blesswater/beermon3/README.md

beermon3

This is the thrid resurection of my beer refrigerator controller.
