blesswater/beermon3/Notes.txt

192.168.166.185 - pi/S...

# To turn On I2C:
    sudo raspi-config 5,P5
#I2C Tools	
    sudo apt-get install -y i2c-tools
    i2cdetect -y 1
    i2cdump -y 1 0x25

# Raspberry Pi Image
    https://www.raspberrypi.org/downloads/raspbian/
    Raspbian Stretch w/ Desktop
    Ver: Oct 2018
    Rel: 10/9/2018
    Ker: 4.14
    SHA-265: 6e3aa76e21473ef316c0bfc9efa5c27a27fe46bd698f71de3e06e66b64a55500

# To get i2c working
https://www.studentcompanion.co.za/pic-microcontroller-communication-with-i2c-bus-mikroc/
https://www.raspberrypi.org/forums/viewtopic.php?t=71639

In /boot/config.txt
    CHANGE: dtparam=i2c_arm=on
    TO: dtparam=i2c_arm=on,i2c_arm_baudrate=32000
    TO: dtparam=i2c_arm=on,i2c_arm_baudrate=16000
->  TO: dtparam=i2c_arm=on,i2c_arm_baudrate=6000

Well... Now 32000 is working

To check:
    xxd /sys/class/i2c-adapter/i2c-1/of_node/clock-frequency
    Should show 7d00

# Assembly
https://en.wikipedia.org/wiki/PIC_instruction_listings

# To build beerChipTempLookup.c
cd ./Controller/beerChip.X
python ./makeBeerChipTempLookup.py > beerChipTempLookup.c

# SQLite3
sudo apt-get install sqlite3

# SQLite Commands
.q For quit
.show
.tables
.schema
.headers on

#
# To create beermon databases
#
CREATE TABLE Project (
    id INTEGER PRIMARY KEY AUTOINCREMENT, 
    proj_name TEXT,
    activity int,
    collection_state TEXT);
# activity: 0 -> inactive (stale) not recording; 
#           1 -> active data is being collected

CREATE TABLE Probes (
    id INTEGER PRIMARY KEY AUTOINCREMENT,
    proj_id INTEGER,
    probe_name TEXT,
    probe_chan INTEGER,
    type VARCHAR(8),
    min_range FLOAT,
    max_range FLOAT,
    control_probe INTEGER );

# Types:
#    NTC_00 -> Thermistor
#    Setpoint -> Control setpoint
#
# control_probe:
#    1 -> Can be used to control the refrigerator
#    0 -> Can not be used to control the refrigerator

CREATE TABLE Temperature (
   id INTEGER PRIMARY KEY AUTOINCREMENT,
   proj_id INTEGER,
   probe_id INTEGER,
   temp_time INTEGER,
   temp FLOAT );

CREATE TABLE Event (
    id INTEGER PRIMARY KEY AUTOINCREMENT,
    proj_id INTEGER,
    event_type TEXT,
    event_time INTEGER );

CREATE TABLE Scalar (
    id INTEGER PRIMARY KEY AUTOINCREMENT,
    type varchar(64),
    value varchar(512) );
or
CREATE TABLE Scalar (
    id INTEGER PRIMARY KEY AUTOINCREMENT,
    type TEXT,
    value TEXT );

# Dealing w/ timestamps
select date(temp_time, 'localtime'), 
       time(temp_time, 'localtime'), 
       datetime(temp_time, 'localtime'), 
       strftime( '%H', temp_time, 'localtime'), 
       temp 
from temperature 
where proj_id=1 and probe_id=3

#
# Session database
#
CREATE TABLE User (
    id INTEGER PRIMARY KEY AUTOINCREMENT,
    username TEXT,
    pwhash TEXT,
    priv INTEGER
);

CREATE TABLE Session (
    id INTEGER PRIMARY KEY AUTOINCREMENT,
    sessId TEXT,
    ipAddr TEXT,
    begin_time INTEGER,
    last_time INTEGER,
    privledge INTEGER
);

#
# Create a Project
#
INSERT INTO Project (proj_name) VALUES ('projName');
INSERT INTO Probes (proj_id, probe_name, probe_chan, type, min_range, max_range, control_probe)
VALUES (projId,'probeName,ch,'NTC_00',30.0, 90.0,cntl); 
INSERT INTO Probes (proj_id, probe_name, probe_chan, type, min_range, max_range, control_probe)
VALUES (projId,'probeName,0,'setpoint',30.0, 90.0,0);

# PW: blabla
INSERT INTO User (username, pwhash, priv)
VALUES ('kiosk', 
        '338466286ab294ab86042620b608b0157c96b9c725138023d68676a64db2cf34325ffb94ded84220f73fb8b5f99a107ca94a0b1647aec2de91e23aa63df36cd0$37a0bf15da254cc2a21b0a887c3ecdf1$',
        3
);

# PW: dontc4r3
INSERT INTO User (username, pwhash, priv)
VALUES ('testuser0',
        'b503cb8df109e6eda7218ae4edc0b31427d5f6eba8fd5d8dfeb9ee857c59ba8b8b8fc7d98ec9085ef5a572e95473f2a83a9d9b4711ca387d58477dec87aac16a$e85409c4cfcc4f0a8c466da3857adb7f$',
        3
);

# Generate PW
python
>>> import hashlib, uuid
>>> salt = uuid.uuid4().hex
>>> phash = hashlib.sha512('blabla' + salt).hexdigest() + '$' + salt + '$'

#
# Kiosk
#
From https://pimylifeup.com/raspberry-pi-kiosk

# Remove Junk
sudo apt-get purge wolfram-engine scratch scratch2 nuscratch sonic-pi idle3 -y
sudo apt-get purge smartsim java-common minecraft-pi libreoffice* -y

sudo apt-get clean
sudo apt-get autoremove -y

sudo apt-get update
sudo apt-get upgrade

# Install tools
sudo apt-get install xdotool unclutter sed

# Verify Autologin
sudo raspi-config
    3 Boot Options -> B1 Desktop / CLI -> B4 Desktop Autologin

# Enable kiosk service
systemctl enable kiosk.service

# uWSGI commands
sudo apt-get install uwsgi-plugin-python

systemctl stop uwsgi.service
uwsgi /etc/uwsgi/uwsgi.ini --honour-stdin

# Information for popups
https://www.w3schools.com/howto/tryit.asp?filename=tryhow_css_login_form_modal    

# Bootstrap
wget https://stackpath.bootstrapcdn.com/bootstrap/4.2.1/css/bootstrap.min.css
wget https://maxcdn.bootstrapcdn.com/bootstrap/4.1.3/js/bootstrap.min.js
<link rel="stylesheet" href="https://use.fontawesome.com/releases/v5.6.3/css/all.css" integrity="sha384-UHRtZLI+pbxtHCWp1t77Bi1L4ZtiqrqD80Kn4Z8NTSRyMA2Fd33n5dQ8lWUE00s/" crossorigin="anonymous">
wget https://use.fontawesome.com/releases/v5.6.3/css/all.css

#
# jQuery-knob
#
git clone https://github.com/aterrien/jQuery-Knob.git

#
# Turn off Beer Services
#
systemctl stop beermon-datacollect.service
systemctl stop beermon-persist.service

#
# Data Collection experiments
#
select datetime(avg(strftime('%s', temp_time)),'unixepoch'), count(*) from Temperature group by strftime('%s', temp_time) / 20 limit 5;

SELECT x.time_group, 
       DATETIME(AVG(STRFTIME('%s',x.centerTime)),'unixepoch'),
       MAX(x.prb1_avg), MAX(x.prb2_avg) 
FROM (
        SELECT CAST(strftime('%s', temp_time) / 20 AS INTEGER) AS time_group, 
            datetime(avg(strftime('%s', temp_time)),'unixepoch') AS centerTime,
            avg(temp) AS prb1_avg,
            0.0 as prb2_avg
        FROM Temperature WHERE probe_id=10
        GROUP BY strftime('%s', temp_time) / 20
    UNION
        SELECT CAST(strftime('%s', temp_time) / 20 AS INTEGER) AS time_group, 
               datetime(avg(strftime('%s', temp_time)),'unixepoch') AS certerTime,
               0.0 AS prb1_avg,
               avg(temp) as prb2_avg
        FROM Temperature WHERE probe_id=11
        GROUP BY strftime('%s', temp_time) / 20
) x GROUP BY x.time_group
