blesswater/beermon3/(list of files, cad)

Other CAD files:
Controller/beerChip.X/l.obj
