blesswater/beermon3/Docs/vma400_scheme.pdf

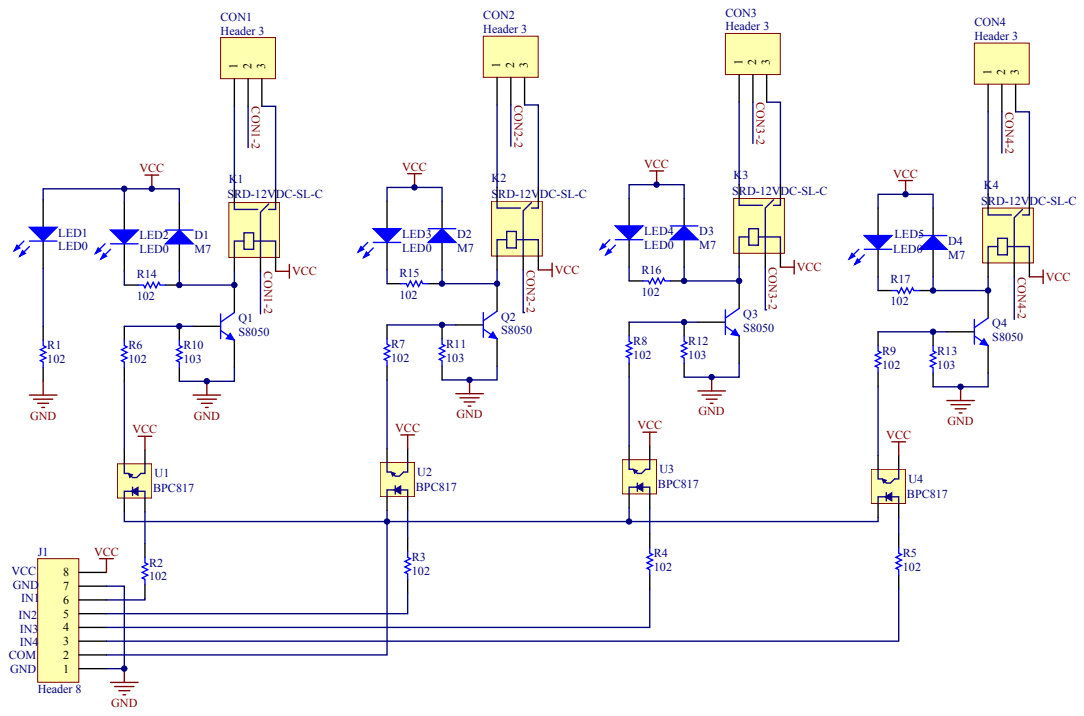
[picture p1: page 1]
