blesswater/beermon3/Hardware/beerSch00.brd

## EAGLE design Hardware/beerSch00.brd (2019-11-11)

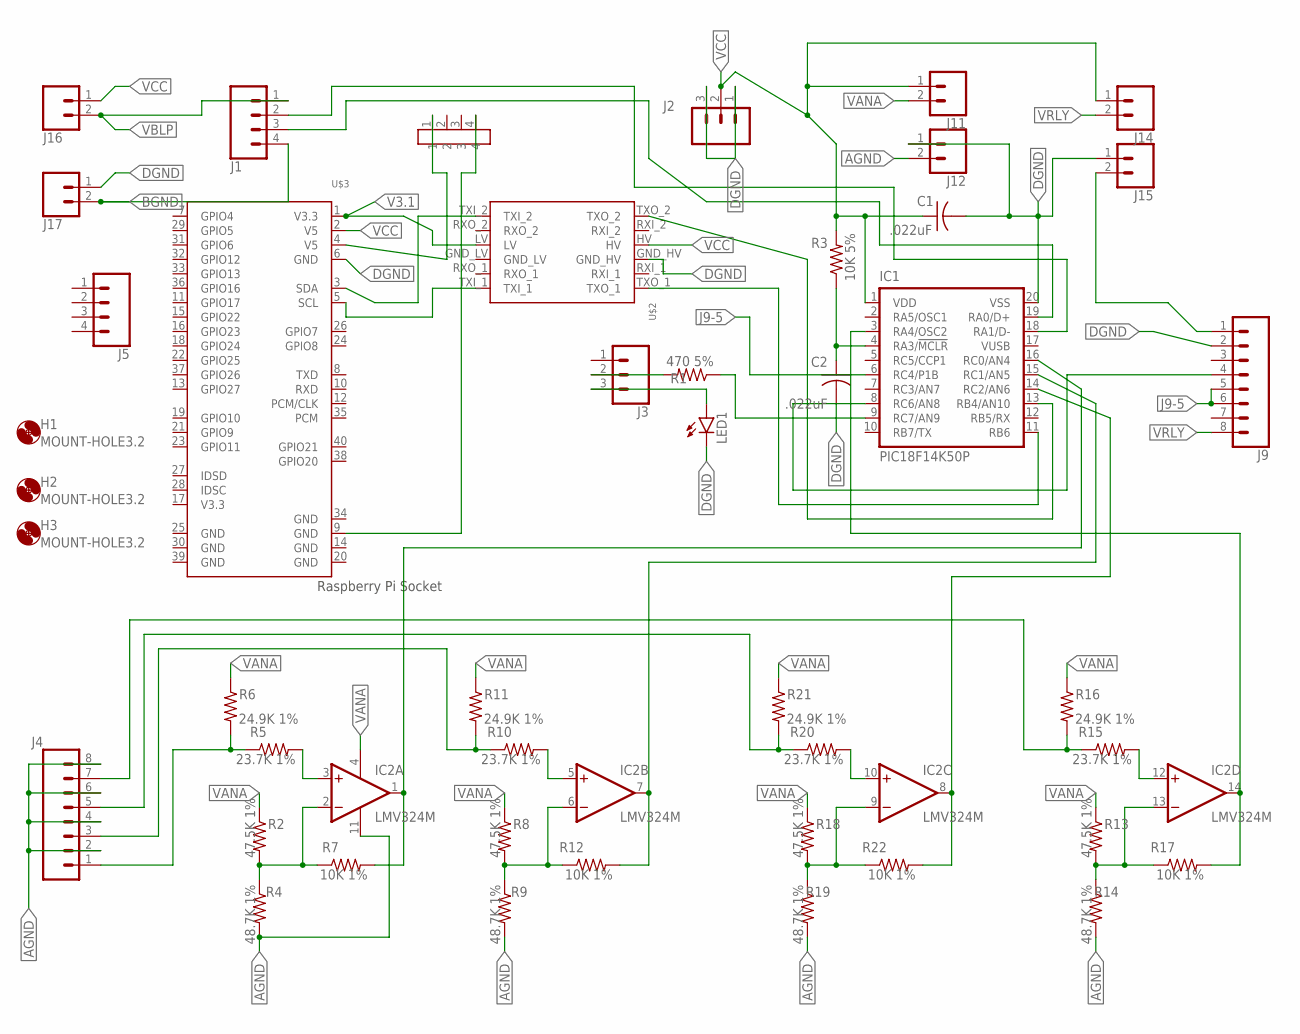
[picture p2: schematic beerSch00.sch]

Parts:
C1, C2: .022uF; C0805
H1, H2, H3: MOUNT-HOLE3.2; 3,2
IC1: PIC18F14K50P; DIL20
IC2: LMV324M; SO14
J1, J5: CONN_04; 1X04
J2, J3: CONN_03; 1X03
J4, J9: CONN_08"; 1X08
J11, J12, J14, J15, J16, J17: CONN_02; 1X02
LED1: LEDSML0805; SML0805
R1: 470 5%; R0603
R2, R8, R13, R18: 47.5K 1%; R0603
R3: 10K 5%; R0603
R4, R9, R14, R19: 48.7K 1%; R0603
R5, R10, R15, R20: 23.7K 1%; R0603
R6, R11, R16, R21: 24.9K 1%; R0603
R7, R12, R17, R22: 10K 1%; R0603
U$1: CONN_4; PINS_90
U$2: LEVELCONV; PLUG_THROUGHHOLE
U$3: RASPBERRYPI_SOCKET_UNDER; RASPBERRYPI_UNDERBD

Connections:
AGND: IC2.11 (V-), J4.2, J4.4, J4.6, J4.8, J12.2, R4.2, R9.2, R14.2, R19.2
BGND: J1.4, J17.2
DGND: C1.2, C2.2, IC1.20 (VSS), J2.1, J2.3, J9.2, J12.1, J15.1, J17.1, LED1.C, U$2.GND_HV, U$3.6 (GND)
J9-5: IC1.6 (RC4/P1B), J9.5, J9.6
unnamed: U$2.TXI_2, U$3.3 (SDA)
unnamed: U$2.TXI_1, U$3.5 (SCL)
unnamed: IC1.13 (RB4/AN10), U$2.TXO_2
unnamed: IC1.11 (RB6), U$2.TXO_1
unnamed: C2.1, IC1.4 (RA3/!MCLR!), R3.1
unnamed: J3.2, R1.2
unnamed: IC1.9 (RC7/AN9), R1.1
unnamed: J3.3, LED1.A
unnamed: IC2.2 (-IN), R2.2, R4.1, R7.1
unnamed: J4.1, R5.1, R6.2
unnamed: IC2.3 (+IN), R5.2
unnamed: IC1.16 (RC0/AN4), IC2.1 (OUT), R7.2
unnamed: IC2.6 (-IN), R8.2, R9.1, R12.1
unnamed: J4.3, R10.1, R11.2
unnamed: IC2.5 (+IN), R10.2
unnamed: J9.1, J15.2
unnamed: U$1.4, U$3.9 (GND)
unnamed: IC2.13 (-IN), R13.2, R14.1, R17.1
unnamed: J4.7, R15.1, R16.2
unnamed: IC2.12 (+IN), R15.2
unnamed: IC1.8 (RC6/AN8), J9.4
unnamed: IC2.9 (-IN), R18.2, R19.1, R22.1
unnamed: J4.5, R20.1, R21.2
unnamed: IC2.10 (+IN), R20.2
unnamed: U$1.1, U$3.4 (V5)
unnamed: IC1.19 (RA0/D+), J1.3
unnamed: IC1.3 (RA4/OSC2), IC2.14 (OUT), R17.2
unnamed: IC1.14 (RC2/AN6), IC2.8 (OUT), R22.2
unnamed: IC1.15 (RC1/AN5), IC2.7 (OUT), R12.2
unnamed: IC1.18 (RA1/D-), J1.2
V3.1: U$2.LV, U$3.1 (V3.3)
VANA: IC2.4 (V+), J11.2, R2.1, R6.1, R8.1, R11.1, R13.1, R16.1, R18.1, R21.1
VBLP: J1.1, J16.2
VCC: C1.1, IC1.1 (VDD), J2.2, J11.1, J14.1, J16.1, R3.2, U$2.HV, U$3.2 (V5)
VRLY: J9.8, J14.2

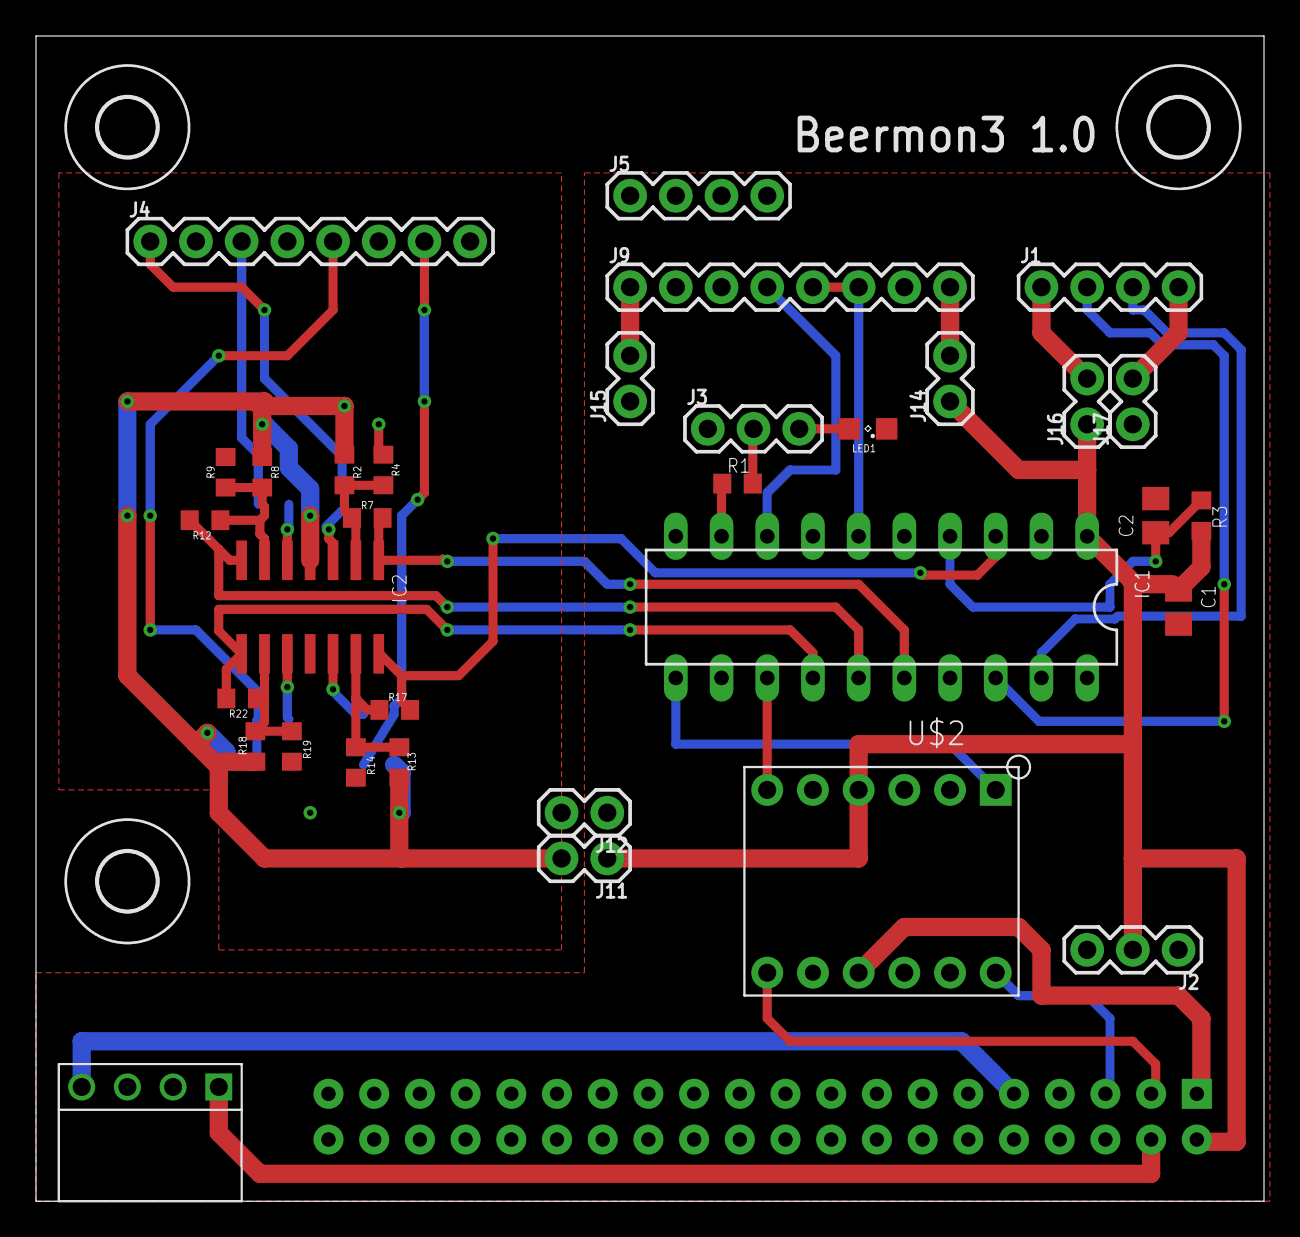
[picture p3: board beerSch00.brd from above]

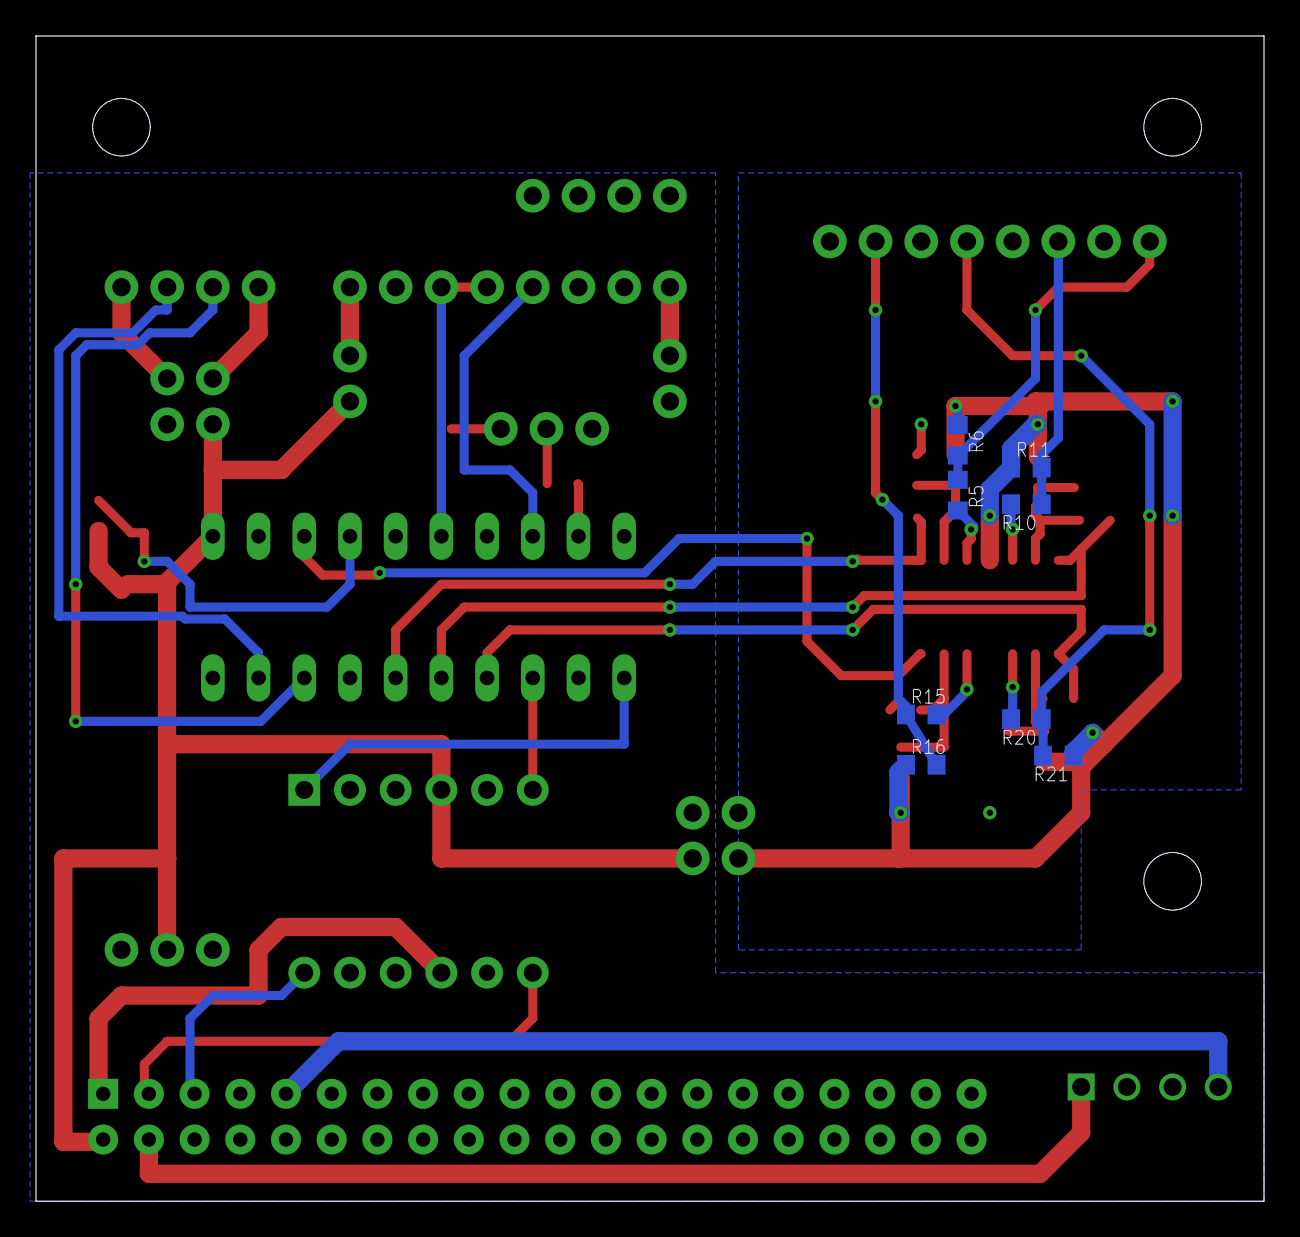
[picture p4: board beerSch00.brd from below]

Board: 2 copper layers, 68.2 x 64.8 mm, 45 parts (8 on the bottom side), 39 nets.
