blesswater/beermon3/Controller/PIC18_Beerchip.X/mcc_generated_files/pin_manager.h

/**
  @Generated Pin Manager Header File

  @Company:
    Microchip Technology Inc.

  @File Name:
    pin_manager.h

  @Summary:
    This is the Pin Manager file generated using PIC10 / PIC12 / PIC16 / PIC18 MCUs

  @Description
    This header file provides APIs for driver for .
    Generation Information :
        Product Revision  :  PIC10 / PIC12 / PIC16 / PIC18 MCUs - 1.65.2
        Device            :  PIC18F14K50
        Driver Version    :  2.11
    The generated drivers are tested against the following:
        Compiler          :  XC8 1.45
        MPLAB 	          :  MPLAB X 4.15	
*/

/*
    (c) 2018 Microchip Technology Inc. and its subsidiaries. 
    
    Subject to your compliance with these terms, you may use Microchip software and any 
    derivatives exclusively with Microchip products. It is your responsibility to comply with third party 
    license terms applicable to your use of third party software (including open source software) that 
    may accompany Microchip software.
    
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
    IN NO EVENT WILL MICROCHIP BE LIABLE FOR ANY INDIRECT, SPECIAL, PUNITIVE, 
    INCIDENTAL OR CONSEQUENTIAL LOSS, DAMAGE, COST OR EXPENSE OF ANY KIND 
    WHATSOEVER RELATED TO THE SOFTWARE, HOWEVER CAUSED, EVEN IF MICROCHIP 
    HAS BEEN ADVISED OF THE POSSIBILITY OR THE DAMAGES ARE FORESEEABLE. TO 
    THE FULLEST EXTENT ALLOWED BY LAW, MICROCHIP'S TOTAL LIABILITY ON ALL 
    CLAIMS IN ANY WAY RELATED TO THIS SOFTWARE WILL NOT EXCEED THE AMOUNT 
    OF FEES, IF ANY, THAT YOU HAVE PAID DIRECTLY TO MICROCHIP FOR THIS 
    SOFTWARE.
*/

#ifndef PIN_MANAGER_H
#define PIN_MANAGER_H

#define INPUT   1
#define OUTPUT  0

#define HIGH    1
#define LOW     0

#define ANALOG      1
#define DIGITAL     0

#define PULL_UP_ENABLED      1
#define PULL_UP_DISABLED     0

// get/set channel_AN3 aliases
#define channel_AN3_TRIS                 TRISAbits.TRISA4
#define channel_AN3_LAT                  LATAbits.LATA4
#define channel_AN3_PORT                 PORTAbits.RA4
#define channel_AN3_WPU                  WPUAbits.WPUA4
#define channel_AN3_ANS                  ANSELbits.ANS3
#define channel_AN3_SetHigh()            do { LATAbits.LATA4 = 1; } while(0)
#define channel_AN3_SetLow()             do { LATAbits.LATA4 = 0; } while(0)
#define channel_AN3_Toggle()             do { LATAbits.LATA4 = ~LATAbits.LATA4; } while(0)
#define channel_AN3_GetValue()           PORTAbits.RA4
#define channel_AN3_SetDigitalInput()    do { TRISAbits.TRISA4 = 1; } while(0)
#define channel_AN3_SetDigitalOutput()   do { TRISAbits.TRISA4 = 0; } while(0)
#define channel_AN3_SetPullup()          do { WPUAbits.WPUA4 = 1; } while(0)
#define channel_AN3_ResetPullup()        do { WPUAbits.WPUA4 = 0; } while(0)
#define channel_AN3_SetAnalogMode()      do { ANSELbits.ANS3 = 1; } while(0)
#define channel_AN3_SetDigitalMode()     do { ANSELbits.ANS3 = 0; } while(0)

// get/set SDA1 aliases
#define SDA1_TRIS                 TRISBbits.TRISB4
#define SDA1_LAT                  LATBbits.LATB4
#define SDA1_PORT                 PORTBbits.RB4
#define SDA1_WPU                  WPUBbits.WPUB4
#define SDA1_ANS                  ANSELHbits.ANS10
#define SDA1_SetHigh()            do { LATBbits.LATB4 = 1; } while(0)
#define SDA1_SetLow()             do { LATBbits.LATB4 = 0; } while(0)
#define SDA1_Toggle()             do { LATBbits.LATB4 = ~LATBbits.LATB4; } while(0)
#define SDA1_GetValue()           PORTBbits.RB4
#define SDA1_SetDigitalInput()    do { TRISBbits.TRISB4 = 1; } while(0)
#define SDA1_SetDigitalOutput()   do { TRISBbits.TRISB4 = 0; } while(0)
#define SDA1_SetPullup()          do { WPUBbits.WPUB4 = 1; } while(0)
#define SDA1_ResetPullup()        do { WPUBbits.WPUB4 = 0; } while(0)
#define SDA1_SetAnalogMode()      do { ANSELHbits.ANS10 = 1; } while(0)
#define SDA1_SetDigitalMode()     do { ANSELHbits.ANS10 = 0; } while(0)

// get/set SCL1 aliases
#define SCL1_TRIS                 TRISBbits.TRISB6
#define SCL1_LAT                  LATBbits.LATB6
#define SCL1_PORT                 PORTBbits.RB6
#define SCL1_WPU                  WPUBbits.WPUB6
#define SCL1_SetHigh()            do { LATBbits.LATB6 = 1; } while(0)
#define SCL1_SetLow()             do { LATBbits.LATB6 = 0; } while(0)
#define SCL1_Toggle()             do { LATBbits.LATB6 = ~LATBbits.LATB6; } while(0)
#define SCL1_GetValue()           PORTBbits.RB6
#define SCL1_SetDigitalInput()    do { TRISBbits.TRISB6 = 1; } while(0)
#define SCL1_SetDigitalOutput()   do { TRISBbits.TRISB6 = 0; } while(0)
#define SCL1_SetPullup()          do { WPUBbits.WPUB6 = 1; } while(0)
#define SCL1_ResetPullup()        do { WPUBbits.WPUB6 = 0; } while(0)

// get/set channel_AN4 aliases
#define channel_AN4_TRIS                 TRISCbits.TRISC0
#define channel_AN4_LAT                  LATCbits.LATC0
#define channel_AN4_PORT                 PORTCbits.RC0
#define channel_AN4_ANS                  ANSELbits.ANS4
#define channel_AN4_SetHigh()            do { LATCbits.LATC0 = 1; } while(0)
#define channel_AN4_SetLow()             do { LATCbits.LATC0 = 0; } while(0)
#define channel_AN4_Toggle()             do { LATCbits.LATC0 = ~LATCbits.LATC0; } while(0)
#define channel_AN4_GetValue()           PORTCbits.RC0
#define channel_AN4_SetDigitalInput()    do { TRISCbits.TRISC0 = 1; } while(0)
#define channel_AN4_SetDigitalOutput()   do { TRISCbits.TRISC0 = 0; } while(0)
#define channel_AN4_SetAnalogMode()      do { ANSELbits.ANS4 = 1; } while(0)
#define channel_AN4_SetDigitalMode()     do { ANSELbits.ANS4 = 0; } while(0)

// get/set channel_AN5 aliases
#define channel_AN5_TRIS                 TRISCbits.TRISC1
#define channel_AN5_LAT                  LATCbits.LATC1
#define channel_AN5_PORT                 PORTCbits.RC1
#define channel_AN5_ANS                  ANSELbits.ANS5
#define channel_AN5_SetHigh()            do { LATCbits.LATC1 = 1; } while(0)
#define channel_AN5_SetLow()             do { LATCbits.LATC1 = 0; } while(0)
#define channel_AN5_Toggle()             do { LATCbits.LATC1 = ~LATCbits.LATC1; } while(0)
#define channel_AN5_GetValue()           PORTCbits.RC1
#define channel_AN5_SetDigitalInput()    do { TRISCbits.TRISC1 = 1; } while(0)
#define channel_AN5_SetDigitalOutput()   do { TRISCbits.TRISC1 = 0; } while(0)
#define channel_AN5_SetAnalogMode()      do { ANSELbits.ANS5 = 1; } while(0)
#define channel_AN5_SetDigitalMode()     do { ANSELbits.ANS5 = 0; } while(0)

// get/set channel_AN6 aliases
#define channel_AN6_TRIS                 TRISCbits.TRISC2
#define channel_AN6_LAT                  LATCbits.LATC2
#define channel_AN6_PORT                 PORTCbits.RC2
#define channel_AN6_ANS                  ANSELbits.ANS6
#define channel_AN6_SetHigh()            do { LATCbits.LATC2 = 1; } while(0)
#define channel_AN6_SetLow()             do { LATCbits.LATC2 = 0; } while(0)
#define channel_AN6_Toggle()             do { LATCbits.LATC2 = ~LATCbits.LATC2; } while(0)
#define channel_AN6_GetValue()           PORTCbits.RC2
#define channel_AN6_SetDigitalInput()    do { TRISCbits.TRISC2 = 1; } while(0)
#define channel_AN6_SetDigitalOutput()   do { TRISCbits.TRISC2 = 0; } while(0)
#define channel_AN6_SetAnalogMode()      do { ANSELbits.ANS6 = 1; } while(0)
#define channel_AN6_SetDigitalMode()     do { ANSELbits.ANS6 = 0; } while(0)

// get/set IO_RC5 aliases
#define IO_RC5_TRIS                 TRISCbits.TRISC5
#define IO_RC5_LAT                  LATCbits.LATC5
#define IO_RC5_PORT                 PORTCbits.RC5
#define IO_RC5_SetHigh()            do { LATCbits.LATC5 = 1; } while(0)
#define IO_RC5_SetLow()             do { LATCbits.LATC5 = 0; } while(0)
#define IO_RC5_Toggle()             do { LATCbits.LATC5 = ~LATCbits.LATC5; } while(0)
#define IO_RC5_GetValue()           PORTCbits.RC5
#define IO_RC5_SetDigitalInput()    do { TRISCbits.TRISC5 = 1; } while(0)
#define IO_RC5_SetDigitalOutput()   do { TRISCbits.TRISC5 = 0; } while(0)

// get/set IO_RC6 aliases
#define IO_RC6_TRIS                 TRISCbits.TRISC6
#define IO_RC6_LAT                  LATCbits.LATC6
#define IO_RC6_PORT                 PORTCbits.RC6
#define IO_RC6_ANS                  ANSELHbits.ANS8
#define IO_RC6_SetHigh()            do { LATCbits.LATC6 = 1; } while(0)
#define IO_RC6_SetLow()             do { LATCbits.LATC6 = 0; } while(0)
#define IO_RC6_Toggle()             do { LATCbits.LATC6 = ~LATCbits.LATC6; } while(0)
#define IO_RC6_GetValue()           PORTCbits.RC6
#define IO_RC6_SetDigitalInput()    do { TRISCbits.TRISC6 = 1; } while(0)
#define IO_RC6_SetDigitalOutput()   do { TRISCbits.TRISC6 = 0; } while(0)
#define IO_RC6_SetAnalogMode()      do { ANSELHbits.ANS8 = 1; } while(0)
#define IO_RC6_SetDigitalMode()     do { ANSELHbits.ANS8 = 0; } while(0)

// get/set IO_RC7 aliases
#define IO_RC7_TRIS                 TRISCbits.TRISC7
#define IO_RC7_LAT                  LATCbits.LATC7
#define IO_RC7_PORT                 PORTCbits.RC7
#define IO_RC7_ANS                  ANSELHbits.ANS9
#define IO_RC7_SetHigh()            do { LATCbits.LATC7 = 1; } while(0)
#define IO_RC7_SetLow()             do { LATCbits.LATC7 = 0; } while(0)
#define IO_RC7_Toggle()             do { LATCbits.LATC7 = ~LATCbits.LATC7; } while(0)
#define IO_RC7_GetValue()           PORTCbits.RC7
#define IO_RC7_SetDigitalInput()    do { TRISCbits.TRISC7 = 1; } while(0)
#define IO_RC7_SetDigitalOutput()   do { TRISCbits.TRISC7 = 0; } while(0)
#define IO_RC7_SetAnalogMode()      do { ANSELHbits.ANS9 = 1; } while(0)
#define IO_RC7_SetDigitalMode()     do { ANSELHbits.ANS9 = 0; } while(0)

/**
   @Param
    none
   @Returns
    none
   @Description
    GPIO and peripheral I/O initialization
   @Example
    PIN_MANAGER_Initialize();
 */
void PIN_MANAGER_Initialize (void);

/**
 * @Param
    none
 * @Returns
    none
 * @Description
    Interrupt on Change Handling routine
 * @Example
    PIN_MANAGER_IOC();
 */
void PIN_MANAGER_IOC(void);



#endif // PIN_MANAGER_H
/**
 End of File
*/
