blesswater/beermon3/DataLogger/logTemp.py

#!/usr/bin/python
import sys
import time
from datetime import datetime, timedelta

from beerChipI2C import beerChipI2C as beerChip
from beerChipDB import beerChipSQLiteDB as beerDB
from beerChipPersistant import beerChipPersistant

recordInterval = 60  # seconds
sleepTime = 0.125 # seconds

def usage():
    print( '' )
    print( 'Usage:')
    print( '    python logTemp.py "DatasetName" ')
    print( '' )

if __name__ == '__main__':
    bc = beerChip( 1, 0x2e )
    dbConn = beerDB()
    dbConn.connect( '/opt/beermon/data/beermonSQLite3DB.db' )

    bcPersist = beerChipPersistant( bc )

    defaultProj = bcPersist.getProject()

    if( len(sys.argv) != 2 ):
        print( 'ERROR: Usage' )
        usage()
        sql = "SELECT proj_name FROM Project"
        print( 'Datasets:')
        print( '\tdefault - %s' % (defaultProj) )
        for proj in dbConn.query( sql ):
            print( '\t%s' % proj[0] )

        dbConn.close()
        sys.exit(1)

    projName = sys.argv[1]
    if( projName.lower() == 'default' ):
        projName = defaultProj
    sql = "SELECT id FROM Project WHERE upper(proj_name) = '%s'" % (projName.upper())
    id = None
    for row in dbConn.query( sql ):
        id = row[0]

    if( id == None ):
        print( 'ERROR: Cannot find Dataset %s' % (projName) )
        print( 'Available Datasets' )
        sql = "SELECT proj_name FROM Project"
        for proj in dbConn.query(sql):
            print('\t%s' % (proj[0]) )

        dbConn.close()
        sys.exit(1)

    probes = []
    sql  = "SELECT probe_name, probe_chan, id, type "
    sql += "FROM Probes "
    sql += "WHERE proj_id = %d " % (id)
    sql += "AND type in ( 'NTC_00', 'setpoint' )"

    for prb in dbConn.query( sql ):
        probes.append( { 'probe_name' : prb[0], 'chan' : prb[1], 'type' : prb[3], 'probe_id' : prb[2], 'data' : 0.0 } )

    if( len( probes ) == 0 ):
        print( 'ERROR: Could not file data sensors for dataset %s' % projName )
        dbConn.close()
        sys.exit(1)

    nextTime = datetime.now()
    bloopSql  = "INSERT INTO Event (proj_id, event_type, event_time) "
    # bloopSql += "VALUES( %d, 'bloop', datetime( 'now' ) ) " % (id)
    bloopSql += "VALUES( %d, 'bloop', strftime('%%Y-%%m-%%d %%H:%%M:%%f', 'now')) " % (id)
    bc.resetBloopDet()

    # Set Project as collecting
    sql  = "UPDATE Project SET collection_state = 'collecting' "
    sql += "WHERE id = %d" % (id)
    dbConn.execute( sql )

    while( True ):
        if( datetime.now() >= nextTime ):
            # print( "Checking Temperature" )
            for prb in probes:
                prb['data'] = bc.getTemperature(prb['chan'], prb['type'])
                # print('%s: %fF' % (prb['probe_name'], prb['data']))

                sql =  "INSERT INTO Temperature (proj_id, probe_id, temp_time, temp) VALUES ( "
                sql += "%d, " % (id)
                sql += "%d, " % (prb['probe_id'])
                sql += "datetime( 'now' ), "
                sql += "%f " % (prb['data'])
                sql += ")"

                dbConn.execute( sql )

            nextTime = datetime.now() + timedelta( seconds=recordInterval )
        else:
            if( bc.isBloopDet() ):
                # print( "Got BLOOP" )
                dbConn.execute( bloopSql )
                bc.ackBloopDet()

        # print( "Sleeping" )
        time.sleep( sleepTime )
