blesswater/beermon3/Controller/beerChip.X/beerChipTempLookup.c

#include <stdint.h>


/*
** Circuit Parameters
**
** Vcc = 5.330000
** R = 24.900000
** Rf = 10.000000
** R1 = 47.500000
** R2 = 48.700000
**
** Ri = 24.046258
** A = 1.415865
** Voff = 1.122105
**
*/


uint8_t tempLookupMsb0( uint8_t index )
{


    asm( "MOVF tempLookupMsb0@index, W" );
    asm( "BRW");
    /* Sample = 0(0x0000), Vrt = 0.792523, Rt = 4.349072, F = 113.149229, 8.8 = 0x7126 */
    asm( "RETLW 0x71" );
    /* Sample = 1(0x0001), Vrt = 0.796199, Rt = 4.372789, F = 112.899888, 8.8 = 0x70E6 */
    asm( "RETLW 0x70" );
    /* Sample = 2(0x0002), Vrt = 0.799875, Rt = 4.396544, F = 112.656937, 8.8 = 0x70A8 */
    asm( "RETLW 0x70" );
    /* Sample = 3(0x0003), Vrt = 0.803551, Rt = 4.420338, F = 112.413591, 8.8 = 0x7069 */
    asm( "RETLW 0x70" );
    /* Sample = 4(0x0004), Vrt = 0.807228, Rt = 4.444170, F = 112.169849, 8.8 = 0x702B */
    asm( "RETLW 0x70" );
    /* Sample = 5(0x0005), Vrt = 0.810904, Rt = 4.468042, F = 111.925711, 8.8 = 0x6FEC */
    asm( "RETLW 0x6F" );
    /* Sample = 6(0x0006), Vrt = 0.814580, Rt = 4.491952, F = 111.681176, 8.8 = 0x6FAE */
    asm( "RETLW 0x6F" );
    /* Sample = 7(0x0007), Vrt = 0.818256, Rt = 4.515901, F = 111.436242, 8.8 = 0x6F6F */
    asm( "RETLW 0x6F" );
    /* Sample = 8(0x0008), Vrt = 0.821933, Rt = 4.539889, F = 111.191303, 8.8 = 0x6F30 */
    asm( "RETLW 0x6F" );
    /* Sample = 9(0x0009), Vrt = 0.825609, Rt = 4.563916, F = 110.956253, 8.8 = 0x6EF4 */
    asm( "RETLW 0x6E" );
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
    asm( "RETLW 0x0D" );
    /* Sample = 766(0x02FE), Vrt = 3.608532, Rt = 52.195262, F = 13.747958, 8.8 = 0x0DBF */
    asm( "RETLW 0x0D" );
    /* Sample = 767(0x02FF), Vrt = 3.612209, Rt = 52.360254, F = 13.637143, 8.8 = 0x0DA3 */
    asm( "RETLW 0x0D" );
}
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
