blesswater/beermon3/DataLogger/beermonConfig.py

beermonConfig = {
    'majVersion' : 0,
    'minVersion' : 0,
    'buildVersion' : 7,
    'dbLocation' : '/opt/beermon/data/beermonSQLite3DB.db',
    'dbSessionLocation' : '/opt/beermon/data/beermonSession.db',
    'i2cBus' : 1,
    'i2cAddr' : 0x2E,

}
