blesswater/beermon3/Controller/beerChip.X/beerChipTempLookup.h

/* 
 * File:   beerChipTempLookup.h
 * Author: BasementPC
 *
 * Created on November 11, 2018, 9:46 PM
 */

#ifndef BEERCHIPTEMPLOOKUP_H
#define	BEERCHIPTEMPLOOKUP_H

#ifdef	__cplusplus
extern "C" {
#endif

int16_t tempLookup( uint16_t index );


#ifdef	__cplusplus
}
#endif

#endif	/* BEERCHIPTEMPLOOKUP_H */
