blesswater/beermon3/Controller/Blinky/blnk_version.h

/* 
 * File:   blnk_version.h
 * Author: BasementPC
 *
 * Created on January 11, 2014, 2:41 AM
 */

#ifndef BLNK_VERSION_H
#define	BLNK_VERSION_H

#ifdef	__cplusplus
extern "C" {
#endif

#define BLNK_PROD_ID  0x07

#define BLNK_MAJ_VER  0x00
#define BLNK_MIN_VER  0x00
#define BLNK_BUILD    0x01

#ifdef	__cplusplus
}
#endif

#endif	/* BLNK_VERSION_H */
