blesswater/beermon3/(commit log)

2018-10-24 Add beerChip Project
    [l.obj]
2018-10-24 Fixed arbituary file locations
    [l.obj]
2018-10-27 Added beerChip.ISR.c
    [l.obj]
2018-10-27 Got timer1 working
    [l.obj]
2018-10-30 Got I2C working
    [l.obj]
2018-10-30 Got LED control
    [l.obj]
2018-11-01 Got locks working
    [l.obj]
2018-11-07 Worked on I2C A/D I/F
    [l.obj]
2018-11-07 Make build
    [l.obj]
2018-11-08 Got Chan 1 A/D working
    [l.obj]
2018-11-08 Version b
    [l.obj]
2018-11-11 Moved LED to RC7
    [l.obj]
2018-11-11 Added calculations
    [Calculations.ods]
2018-11-21 Build beerChipTempLookup.c
    [Calculations.ods, l.obj]
2018-11-21 Before temp reading trigger
    [l.obj]
2018-11-21 Fixed bug in temp lookup
    [l.obj]
2018-11-22 Add user timer
2018-11-22 Added User timer to project
    [l.obj]
2018-11-22 Test commit
    [l.obj]
2018-11-22 Add relay board schematic
2018-11-24 Add relays and testing
2018-11-24 Test CI
    [l.obj]
2018-11-24 Remove relay test code
    [l.obj]
2018-11-26 Add config to I2C
2018-12-01 Fix stopwatch
    [l.obj]
2018-12-01 Add start control
    [Calculations.ods, l.obj]
2018-12-01 Add i2c configuration
    [l.obj]
2018-12-21 Get temperature stats
2018-12-25 Data timer
2019-01-13 Add Probe select
2019-01-19 added Activets button
2019-01-19 Get rig of LEDs
2019-02-18 Added all I2C functionality
2019-02-22 Fix Timers st startup
    [l.obj]
2019-02-26 Add probe 2
    [l.obj]
2019-03-02 Got 3 A/D Working
    [l.obj]
2019-03-04 Add 4 a/D chan
    [l.obj]
2019-06-08 Add manual probes and cut sdev
2019-06-08 cut sdev
2019-06-29 Add makeBeerChipTempSpreadsheet.py
    [TempTable.csv]
2019-06-29 MCLR Fix - late checkin
    [beerChipConfig.h, beerChipISR.c, beerChipMain.c, beerChipRelay.h]
2019-06-29 Changed Low Voltage Program Config
2019-07-21 Add LED flash and bloopmon
2019-10-20 query Temperature
2019-11-11 Add schematic
    [beerSch00.brd, beerSch00.sch]
2019-11-30 Removed zeros in temperature query
2019-12-14 Fix service and i2c group
